TH4R4V3N1324/hexapod-hardware/explorer/README.md

# Explorer

> ⚠️ **v0.2: under development, not ready to build yet.** Parts, BOM and instructions are incomplete and may change without notice.

- [Print list](print-list.md)
- [Bill of materials](bom.csv)
- [Wiring](wiring.md)
- [Assembly](assembly/README.md)
- [Changelog](CHANGELOG.md)
