TH4R4V3N1324/hexapod-hardware/(list of files, cad)

Other CAD files:
electronics/leg-hub/3dmodels/Molex_Micro-Fit_3.0_43650-0200_1x02_P3.00mm_Horizontal.step
explorer/body/pi-shelf.step
explorer/camera-pod/camera-pod-shell.step
explorer/legs/bearing-spacer.step
electronics/leg-hub/3dmodels/Infineon_PG-TDSON-8_6.15x5.15mm.step
explorer/body/body.step
explorer/camera-pod/camera-pod-plate.step
explorer/legs/tibia-cartridge.step
electronics/leg-hub/3dmodels/Molex_SPOX_5267-03A_1x03_P2.50mm_Vertical.step
explorer/body/body-lid.step
explorer/legs/shank.step
electronics/leg-hub/3dmodels/AMASS_XT30PW-M_1x02_P2.50mm_Horizontal.step
explorer/legs/coxa-B.step
explorer/legs/femur-panel.step
explorer/legs/coxa-A.step
explorer/legs/femur-B.step
explorer/legs/leg-mount.step
explorer/legs/femur-A.step
explorer/legs/joint-cap.step
explorer/legs/leg-mount-cap.step
explorer/legs/foot.step
explorer/legs/coxa-panel.step
explorer/legs/tibia.step
explorer/body/body-lid.stl
explorer/body/body.stl
explorer/body/pi-shelf.stl
explorer/camera-pod/camera-pod-plate.stl
explorer/camera-pod/camera-pod-shell.stl
explorer/legs/bearing-spacer.stl
explorer/legs/coxa-A.stl
explorer/legs/coxa-B.stl
explorer/legs/coxa-panel.stl
explorer/legs/femur-A.stl
explorer/legs/femur-B.stl
explorer/legs/femur-panel.stl
explorer/legs/foot.stl
explorer/legs/joint-cap.stl
explorer/legs/leg-mount-cap.stl
explorer/legs/leg-mount.stl
explorer/legs/shank.stl
explorer/legs/tibia-cartridge.stl
explorer/legs/tibia.stl
