TH4R4V3N1324/hexapod-hardware/electronics/leg-hub/leg-hub.kicad_pcb

## KiCad design electronics/leg-hub/leg-hub.kicad_pcb (2026-11-12)

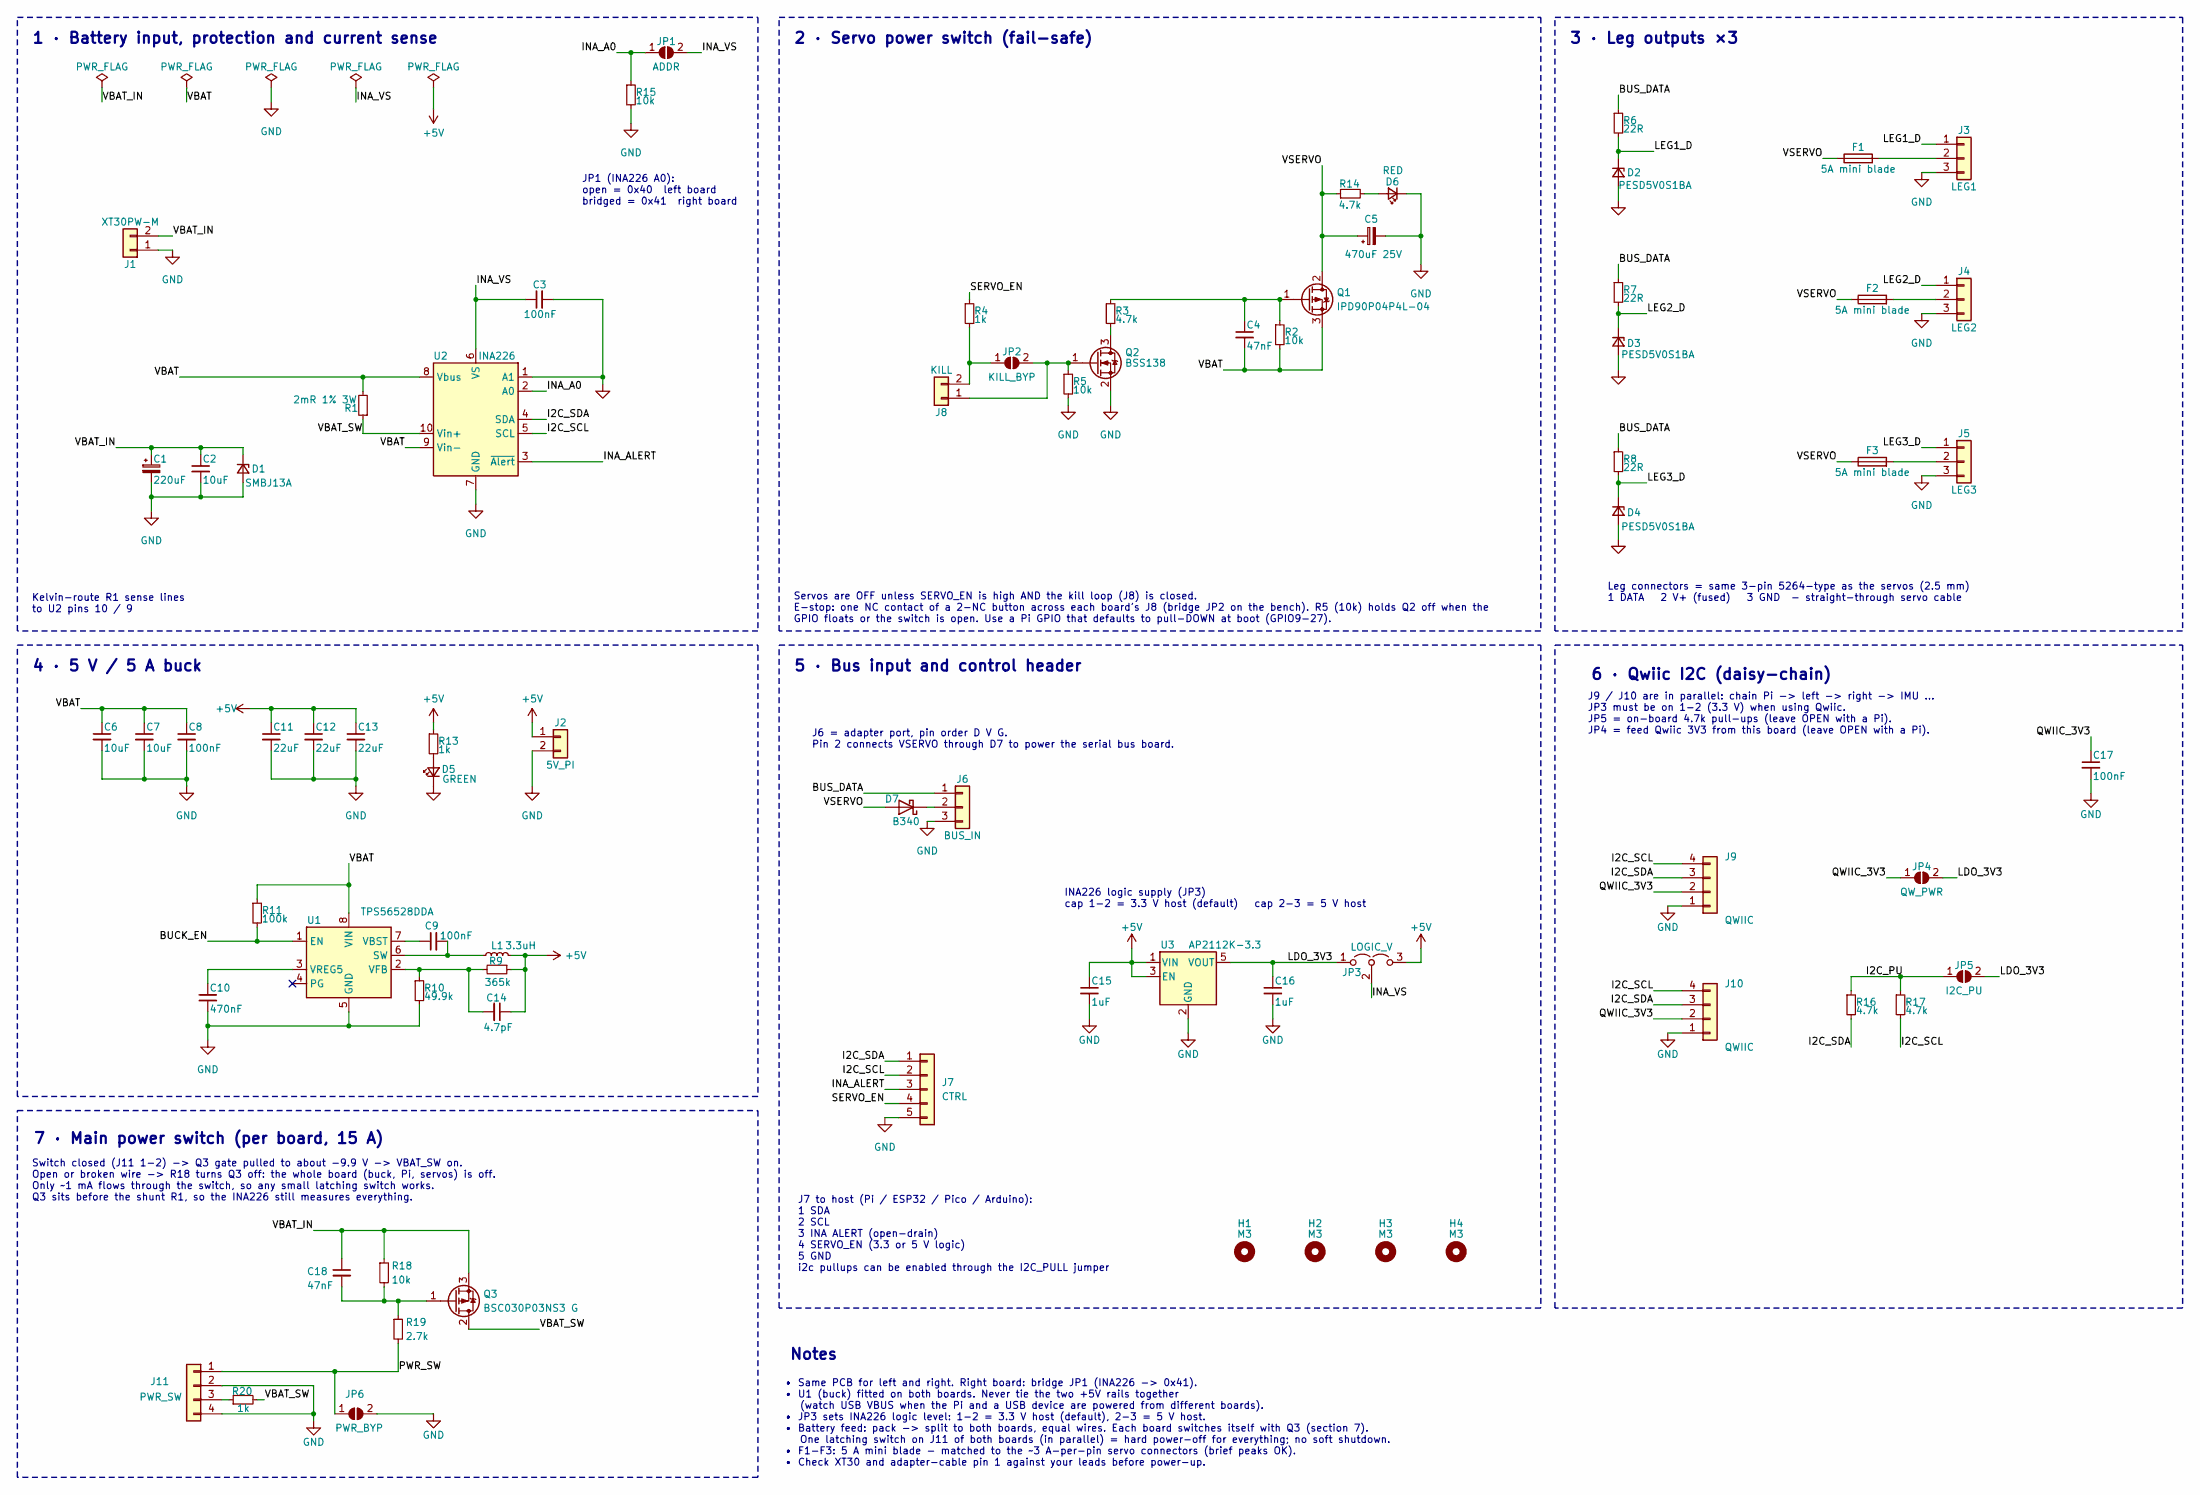
[picture p2: schematic leg-hub.kicad_sch, Hexapod V6 - leg hub (L/R)]

Parts:
C1: 220uF; CP_Elec_8x10.5
C2, C6, C7: 10uF; C_1206_3216Metric
C3, C8, C9, C17: 100nF; C_0603_1608Metric
C4, C18: 47nF; C_0603_1608Metric
C5: 470uF 25V; CP_Elec_10x10.5
C10: 470nF; C_0603_1608Metric
C11, C12, C13: 22uF; C_1206_3216Metric
C14: 4.7pF; C_0603_1608Metric
C15, C16: 1uF; C_0603_1608Metric
D1: SMBJ13A; D_SMB; MPN SMBJ13A
D2, D3, D4: PESD5V0S1BA; D_SOD-323; MPN PESD5V0S1BA
D5: GREEN; LED_0603_1608Metric
D6: RED; LED_0603_1608Metric
D7: B340; D_SMC
F1, F2, F3: 5A mini blade; Fuseholder_Blade_Mini_Keystone_3568; MPN Keystone 3568 + 5 A mini blade fuse
H1, H2, H3, H4: M3; MountingHole_3.2mm_M3
J1: XT30PW-M; AMASS_XT30PW-M_1x02_P2.50mm_Horizontal; MPN Amass XT30PW-M
J2: 5V_PI; Molex_Micro-Fit_3.0_43650-0200_1x02_P3.00mm_Horizontal; MPN Molex 43650-0200
J3: LEG1; Molex_SPOX_5267-03A_1x03_P2.50mm_Vertical; MPN Molex 5267-03A
J4: LEG2; Molex_SPOX_5267-03A_1x03_P2.50mm_Vertical; MPN Molex 5267-03A
J5: LEG3; Molex_SPOX_5267-03A_1x03_P2.50mm_Vertical; MPN Molex 5267-03A
J6: BUS_IN; Molex_SPOX_5267-03A_1x03_P2.50mm_Vertical; MPN Molex 5267-03A
J7: CTRL; JST_PH_S5B-PH-K_1x05_P2.00mm_Horizontal
J8: KILL; JST_PH_S2B-PH-K_1x02_P2.00mm_Horizontal; MPN JST S2B-PH-K-S
J9, J10: QWIIC; JST_SH_SM04B-SRSS-TB_1x04-1MP_P1.00mm_Horizontal; MPN JST SM04B-SRSS-TB(LF)(SN) (LCSC C160404)
J11: PWR_SW; JST_PH_S4B-PH-K_1x04_P2.00mm_Horizontal
JP1: ADDR; SolderJumper-2_P1.3mm_Open_RoundedPad1.0x1.5mm
JP2: KILL_BYP; SolderJumper-2_P1.3mm_Open_RoundedPad1.0x1.5mm
JP3: LOGIC_V; PinHeader_1x03_P2.54mm_Vertical
JP4: QW_PWR; SolderJumper-2_P1.3mm_Open_RoundedPad1.0x1.5mm
JP5: I2C_PU; SolderJumper-2_P1.3mm_Open_RoundedPad1.0x1.5mm
JP6: PWR_BYP; SolderJumper-2_P1.3mm_Open_RoundedPad1.0x1.5mm
L1: 3.3uH; L_Coilcraft_XAL7030-332; MPN Coilcraft XAL7030-332
Q1: IPD90P04P4L-04; TO-252-3_TabPin2; MPN IPD90P04P4L-04
Q2: BSS138; SOT-23; MPN BSS138
Q3: BSC030P03NS3 G; TDSON-8_GDS; MPN BSC030P03NS3 G
R1: 2mR 1% 3W; R_2512_6332Metric
R2, R5, R15, R18: 10k; R_0603_1608Metric
R3, R14, R16, R17: 4.7k; R_0603_1608Metric
R4, R13: 1k; R_0603_1608Metric
R6, R7, R8: 22R; R_0603_1608Metric
R9: 365k; R_0603_1608Metric
R10: 49.9k; R_0603_1608Metric
R11: 100k; R_0603_1608Metric
R19: 2.7k; R_0603_1608Metric
R20: 1k; R_1206_3216Metric
U1: TPS56528DDA; Texas_HSOP-8-1EP_3.9x4.9mm_P1.27mm_ThermalVias; MPN TPS56528DDAR
U2: INA226; TSSOP-10_3x3mm_P0.5mm; MPN INA226AIDGSR
U3: AP2112K-3.3; SOT-23-5

Connections:
+5V: C11.1, C12.1, C13.1, C14.1, C15.1, J2.1, JP3.3 (B), L1.2, R9.1, R13.1, U3.1 (VIN), U3.3 (EN)
/BUCK_EN: R11.2, U1.1 (EN)
/BUS_DATA: J6.1, R6.1, R7.1, R8.1
/I2C_PU: JP5.1 (A), R16.1, R17.1
/I2C_SCL: J7.2, J9.4, J10.4, R17.2, U2.5 (SCL)
/I2C_SDA: J7.1, J9.3, J10.3, R16.2, U2.4 (SDA)
/INA_A0: JP1.1 (A), R15.1, U2.2 (A0)
/INA_ALERT: J7.3, U2.3 (~Alert)
/INA_VS: C3.1, JP1.2 (B), JP3.2 (C), U2.6 (VS)
/LDO_3V3: C16.1, JP3.1 (A), JP4.2 (B), JP5.2 (B), U3.5 (VOUT)
/LEG1_D: D2.1 (K), J3.1, R6.2
/LEG2_D: D3.1 (K), J4.1, R7.2
/LEG3_D: D4.1 (K), J5.1, R8.2
/PWR_SW: J11.1, JP6.1 (A), R19.2
/QWIIC_3V3: C17.1, J9.2, J10.2, JP4.1 (A)
/SERVO_EN: J7.4, R4.1
/VBAT: C4.2, C6.1, C7.1, C8.1, Q1.3 (S), R1.2, R2.2, R11.1, U1.8 (VIN), U2.8 (Vbus), U2.9 (Vin-)
/VBAT_IN: C1.1, C2.1, C18.1, D1.1 (K), J1.2, Q3.3 (S), R18.1
/VBAT_SW: Q3.2 (D), R1.1, R20.2, U2.10 (Vin+)
/VSERVO: C5.1, D7.2 (A), F1.1, F2.1, F3.1, Q1.2 (D), R14.1
GND: C1.2, C2.2, C3.2, C5.2, C6.2, C7.2, C8.2, C10.2, C11.2, C12.2, C13.2, C15.2, C16.2, C17.2, D1.2 (A), D2.2 (A), D3.2 (A), D4.2 (A), D5.1 (K), D6.1 (K), J1.1, J2.2, J3.3, J4.3, J5.3, J6.3, J7.5, J9.1, J10.1, J11.2, J11.4, JP6.2 (B), Q2.2 (S), R5.2, R10.2, R15.2, U1.5 (GND), U1.9 (GND), U2.1 (A1), U2.7 (GND), U3.2 (GND)
unnamed: D5.2 (A), R13.2
unnamed: D6.2 (A), R14.2
unnamed: D7.1 (K), J6.2
unnamed: F1.2, J3.2
unnamed: F2.2, J4.2
unnamed: F3.2, J5.2
unnamed: J8.1, JP2.2 (B), Q2.1 (G), R5.1
unnamed: J8.2, JP2.1 (A), R4.2
unnamed: J11.3, R20.1
unnamed: C4.1, Q1.1 (G), R2.1, R3.1
unnamed: Q2.3 (D), R3.2
unnamed: C18.2, Q3.1 (G), R18.2, R19.1
unnamed: C9.2, L1.1, U1.6 (SW)
unnamed: C9.1, U1.7 (VBST)
unnamed: C14.2, R9.2, R10.1, U1.2 (VFB)
unnamed: C10.1, U1.3 (VREG5)

Notes on the sheet:
2 · Servo power switch (fail-safe)
4 · 5 V / 5 A buck
Kelvin-route R1 sense lines to U2 pins 10 / 9
1 · Battery input, protection and current sense
5 · Bus input and control header
Notes
7 · Main power switch (per board, 15 A)
Servos are OFF unless SERVO_EN is high AND the kill loop (J8) is closed. E-stop: one NC contact of a 2-NC button across each board's J8 (bridge JP2 on the bench). R5 (10k) holds Q2 off when the GPIO floats or the switch is open. Use a Pi GPIO that defaults to pull-DOWN at boot (GPIO9-27).
J6 = adapter port, pin order D V G. Pin 2 connects VSERVO through D7 to power the serial bus board.
JP1 (INA226 A0): open = 0x40 left board bridged = 0x41 right board
6 · Qwiic I2C (daisy-chain)
3 · Leg outputs ×3
Leg connectors = same 3-pin 5264-type as the servos (2.5 mm) 1 DATA 2 V+ (fused) 3 GND - straight-through servo cable
• Same PCB for left and right. Right board: bridge JP1 (INA226 -> 0x41). • U1 (buck) fitted on both boards. Never tie the two +5V rails together (watch USB VBUS when the Pi and a USB device are powered from different boards). • JP3 sets INA226 logic level: 1-2 = 3.3 V host (default), 2-3 = 5 V host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
INA226 logic supply (JP3) cap 1-2 = 3.3 V host (default) cap 2-3 = 5 V host
J9 / J10 are in parallel: chain Pi -> left -> right -> IMU ... JP3 must be on 1-2 (3.3 V) when using Qwiic. JP5 = on-board 4.7k pull-ups (leave OPEN with a Pi). JP4 = feed Qwiic 3V3 from this board (leave OPEN with a Pi).
Switch closed (J11 1-2) -> Q3 gate pulled to about -9.9 V -> VBAT_SW on. Open or broken wire -> R18 turns Q3 off: the whole board (buck, Pi, servos) is off. Only ~1 mA flows through the switch, so any small latching switch works. Q3 sits before the shunt R1, so the INA226 still measures everything.
J7 to host (Pi / ESP32 / Pico / Arduino): 1 SDA 2 SCL 3 INA ALERT (open-drain) 4 SERVO_EN (3.3 or 5 V logic) 5 GND i2c pullups can be enabled through the I2C_PULL jumper

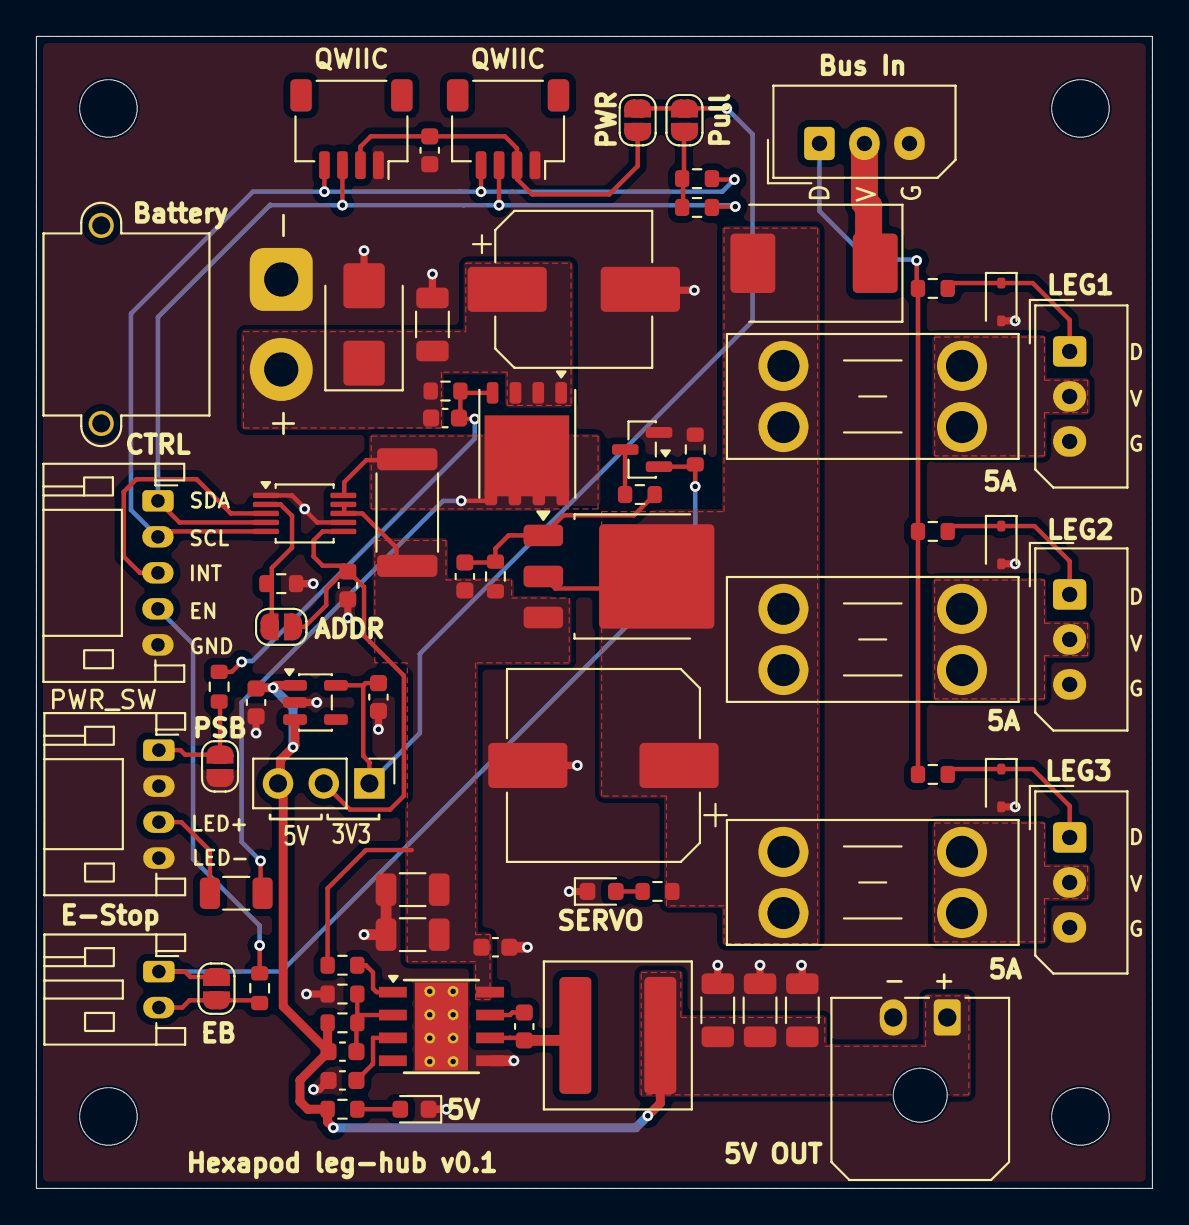
[picture p3: board leg-hub.kicad_pcb from above]

Board: 2 copper layers, 62.0 x 64.0 mm, 75 parts (0 on the bottom side), 37 nets.
