TH4R4V3N1324/hexapod-hardware/(commit log)

2026-11-11 Track CAD binaries with Git LFS
2026-11-11 Update .gitattributes to enable automatic text handling and clean up .gitignore by removing BOM file exclusions
2026-11-11 Add Explorer v0.1 CAD, docs and licences
    Explorer v0.1 is the first public CAD (internal V6.1). It is still
    in development and not ready to build yet.
    - explorer/: STEP and STL files for the body, camera pod and legs.
    Also a README with a status line, a print list with quantities
    and recommended materials, a BOM header, and a changelog.
    Placeholder files for wiring and assembly.
    - Licences: CC BY-SA 4.0 for CAD, STLs and docs (root LICENSE).
    CERN-OHL-W-2.0 for the PCB designs (electronics/LICENSE).
    - Root README: intro, variants table and licences section.
    [body-lid.step, body-lid.stl, body.step, body.stl, bom.csv, camera-pod-plate.step, camera-pod-plate.stl, camera-pod-shell.step]
2026-11-12 Add leg hub v0.1 board
    Power and data board for one side of the hexapod (two per robot):
    fused servo power and data to three legs, 5 V / 5 A output, INA226
    current sensing, fail-safe servo switch and a latching board switch.
    Includes the KiCad 10 project, custom TDSON-8 footprint and 3D models,
    README with connectors, jumpers and wiring, and power-flow diagrams.
    Renames electronics/breakout to electronics/leg-hub.
    [AMASS_XT30PW-M_1x02_P2.50mm_Horizontal.step, Infineon_PG-TDSON-8_6.15x5.15mm.step, Molex_Micro-Fit_3.0_43650-0200_1x02_P3.00mm_Horizontal.step, Molex_SPOX_5267-03A_1x03_P2.50mm_Vertical.step, leg-hub.kicad_pcb, leg-hub.kicad_sch]
2026-11-14 Redesigned tibia cartridge to be top loaded with looser tolerancing, too tight of a tolerance crushes the outer shell of the bearing causing the linear guide rods to bind
    Slightly loosened the tolerance on the shank to allow for better insertion of the linear guide rods
    [bearing-spacer.step, bearing-spacer.stl, shank.step, shank.stl, tibia-cartridge.step, tibia-cartridge.stl]
2026-11-14 Update Explorer variant to v0.2, including redesigned tibia cartridge and new bearing spacers
